antoinecellerier/lowpower-epaper-thermometer/hardware/thermometer-c6/HAND-ROUTING.md

# Hand placing & routing workflow (KiCad GUI → generator harvest)

The generated `thermometer-c6.kicad_pcb` is never hand-edited. All GUI work
happens on a copy; results flow back into `generator/pcb_layout.py` and are
re-rendered. Worklist: whatever `verify/drc_summary.py --gate` and
`verify/hand_diff.py` report. (It used to be `out/stragglers.txt`, but that file
is written only by the retired `make route`, and the board has been
0-unconnected since the J4 fanout harvest.)

**Division of labour:** steps 1–2 (and 4's GUI half) are the human part.
Steps 3, 5, 6 and the PLACE mirroring are mechanical — tell Claude which
nets you routed / which refs you moved and where the copy lives (default
`out/hand/`), and it ports everything back, gates, and commits.

## 0. Preconditions

```bash
make check          # must be fully green
make pcb            # fresh render of placement + checked-in routes
```

## 1. Make the working copy

```bash
make hand
```

Open `out/hand/thermometer-c6.kicad_pcb`. Same basenames = the GUI DRC
enforces the real rules (0.2mm netclass clearance, HV 0.3mm, 0.18mm inside
the `fpc-fanout` area, 0.5mm power widths). `out/` is gitignored.

The target copies the `.kicad_dru` along — **do not skip it.** Without it the
GUI, and any `kicad-cli pcb drc` run from that directory, silently drops every
scoped waiver rule and reports violations the real board does not have (68 vs
7, observed 2026-07-20).

It also symlinks `local.3dmodels/` into the copy, so the local STEP models
(MINI-1, USB-C, FPC, JST, both Bosch LGAs, the switch) render in the GUI's 3D
viewer. The board stores model paths as `${KIPRJMOD}/local.3dmodels/…`, and
`KIPRJMOD` resolves to whatever directory holds the `.kicad_pro` — so without
the link those parts show as bare pads in `out/hand/` while looking fine at
the top level.

`make hand` refuses if the existing copy is newer than the generated board,
since that means un-harvested GUI edits; `make hand FORCE=1` discards them.

## 2. Route in the GUI

- Targets: whatever the gate reports unrouted. Ignore GND ratsnest —
  it waits for the M6 pour.
- Route the NE-gate cluster (`EPD_CS`/`EPD_DC`/`EPD_RST`/`EPD_BUSY`/
  `~EPD_VPP`) in one sitting: the five contend for the same gate, partial
  harvests there invalidate each other.
- You may rip and re-route existing copper, but nothing regenerates it: since
  M5 `pcb_routes.py` **is** the copper, so anything you rip has to come back
  through the step 3 harvest. Treat *authored* copper as expensive to move (see
  `verify/net.py NET` — authored islands are listed with their `pcb_layout.py`
  line numbers).

## 3. Harvest tracks/vias back into the generator

Since M5 the whole board is hand-routed and `pcb_routes.py` is the copper
source of truth — harvest wholesale:

```bash
python3 generator/extract_tracks.py out/hand/thermometer-c6.kicad_pcb --all \
    -o generator/pcb_routes.py
python3 generator/pcb.py     # re-render, then gate (step 5)
```

Always use `-o` (atomic write) — **never a shell `>` redirect**, which
truncates `pcb_routes.py` before the harvester's own imports run.
Anonymous nets are renamed to their `~` names automatically (needs
`out/netlist.net`; run `make netlist` once if missing). Per-net mode
(`... NET [NET ...]`, prints entries for pasting) still exists for
surgical work.

## 3.5. Audit unharvested edits

`extract_tracks.py` mirrors only signal copper (GND excluded). Everything
else — placement, GND vias/tracks, silk, copper graphics, outline — is
hand-mirrored and easy to forget. Audit the whole round-trip:

```bash
python3 verify/hand_diff.py            # must exit 0 before the gate
python3 verify/hand_diff.py --apply    # mirror placement + STITCH vias
```

`--apply` writes the moved-footprint `PLACE` tuples and added/removed GND
`STITCH` vias into `pcb_layout.py` (unique line match required, atomic
write), then tells you to regenerate. GND tracks, silk, copper graphics and
signal-copper sync are report-only — harvest them per the report's hints.
hand_diff must exit 0 (fully mirrored) before step 5's gate.

## 4. Placement tweaks (two traps)

- Nothing harvests placement automatically. `hand_diff` catches this — its
  A section reports every moved/rotated/flipped footprint and `--apply`
  writes the `pcb_layout.PLACE` tuple for you. By hand the entries are
  `(x, y, rot[, "B"])` in **board-relative mm, origin (100,100)** — subtract
  100 from each KiCad-shown absolute coordinate; rotation is
  `SetOrientationDegrees` semantics (what the GUI shows).
- Authored TRACKS/VIAS are absolute coordinates and do **not** follow a
  moved component. hand_diff catches this too: its A section WARNs when a
  move orphans authored copper (a TRACKS vertex, VIA or STITCH via) inside
  the old courtyard. Moving anything inside a hand-authored cluster (FPC
  fanout, booster core, NE-gate copper, EPD_VCC spine) orphans that copper
  and it must be re-authored. Cheapest tweaks are in the all-A* west/center
  signal field; the east side is expensive.
- Known negative result: moving C10/R9 does NOT free `XTAL_32K_P`;
  [PATHFINDER-NOTES Stage 2](PATHFINDER-NOTES.md#stage-2-movable-authored-copper--feasibility-proven)
  holds the acid test.

## 5. Gate every iteration

```bash
make check
python3 verify/hand_diff.py            # exit 0 = every GUI edit mirrored
python3 verify/drc_summary.py --gate   # REAL=0 required
python3 verify/check_pcb.py            # trunk width, keep-out intersects
```

Unconnected items must be GND-only (the M6 pour owns GND). Beware stale
`out/drc.json` — regenerate before reading it.

## 6. Commit

Commit `pcb_layout.py` + regenerated `pcb_routes.py` + board file together
(one cluster per commit, imperative message). If a pass leaves dangling
authored copper on a *routed* net, the router bypassed your stub — delete it.

Then refresh the working copy from the freshly rendered board (step 1's `cp`
again) so the next GUI session starts from the generator's truth. Do it only
once hand_diff has nothing left to report but differences the harvest is
*meant* to absorb — pcb.py drops copper the GUI left redundant (a segment
lying wholly inside a longer collinear one on the same net/layer) and carries
any generator-side geometry fix you made on top of the harvest, and those two
are the only reasons the round-trip legitimately does not close.

## Debugging a stubborn net

`verify/reach.py NET W out.png` first (flood fill from the seed island —
shows exactly where it is walled in), then `who.py`/`gap.py`/`occupancy.py`
(the `pcb-edit` skill indexes them). Corridor truths live in LAYOUT-PLAN.md's M5
survey; router semantics (seeding, ordering, boxes) in ROUTER-NOTES.md.
