antoinecellerier/lowpower-epaper-thermometer/hardware/thermometer-c6/thermometer-c6.kicad_pcb

## KiCad design hardware/thermometer-c6/thermometer-c6.kicad_pcb (2026-10-27)

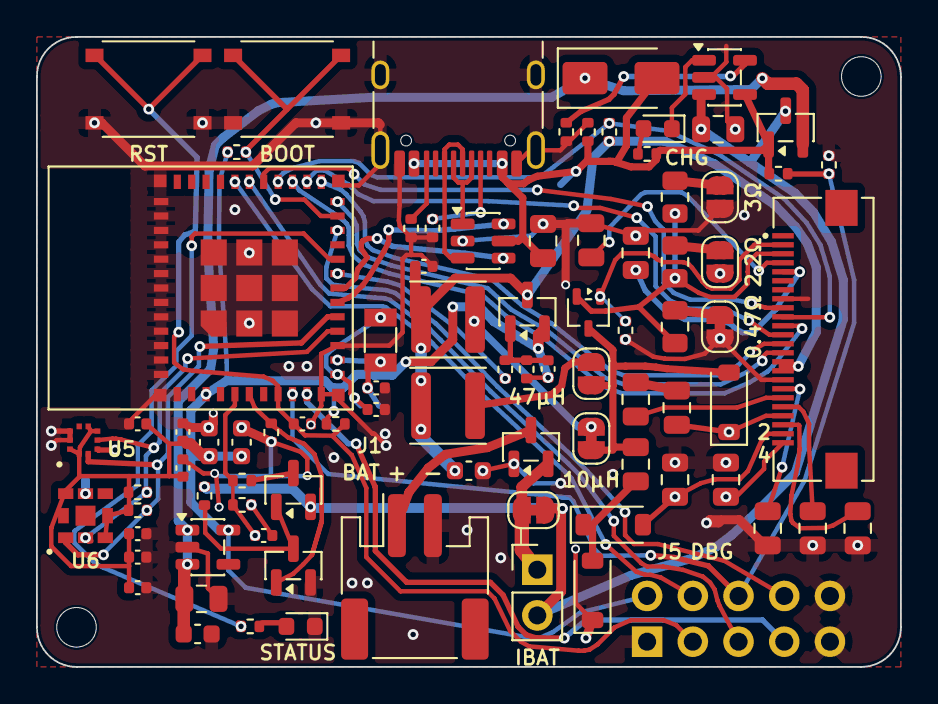
[picture p11: board thermometer-c6.kicad_pcb from above]

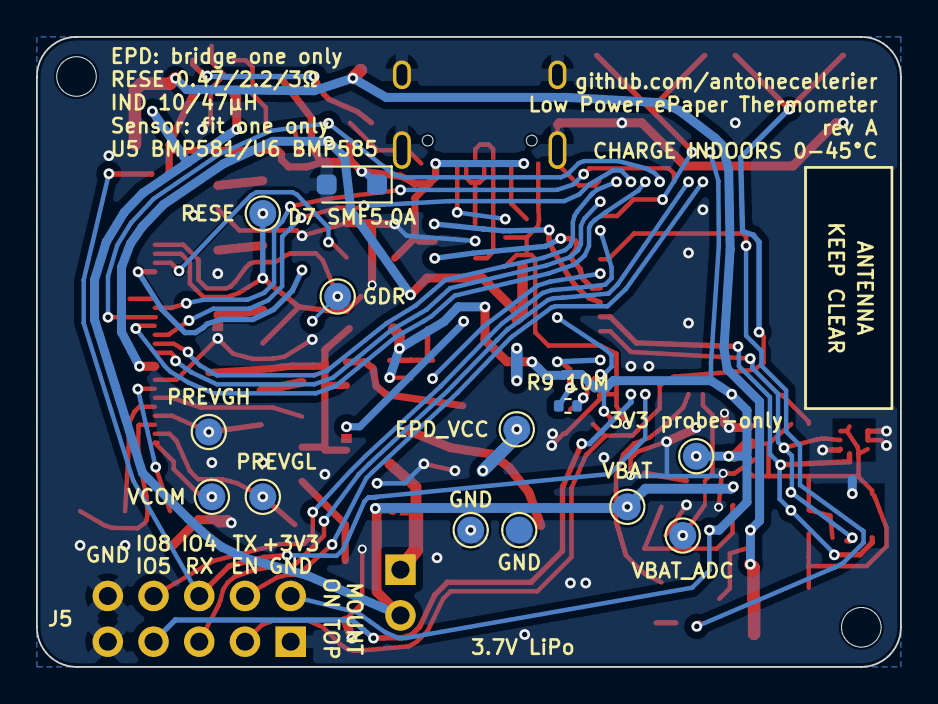
[picture p12: board thermometer-c6.kicad_pcb from below]

Board: 2 copper layers, 48.0 x 35.0 mm, 101 parts (13 on the bottom side), 60 nets.

Parts:
C1, C3, C7, C14: 10uF; C_0603_1608Metric
C2: 22uF/25V; C_0805_2012Metric
C4, C8, C12, C13, C15, C26, C27: 100nF; C_0402_1005Metric
C5, C6, C16, C17, C18, C19, C20, C23, C24: 4.7uF/50V; C_0805_2012Metric
C9: 1uF; C_0402_1005Metric
C10, C11: 20pF; C_0402_1005Metric
C21, C22, C25: 1uF/50V; C_0805_2012Metric
C28, C29: 10nF; C_0402_1005Metric
D1: CHG red; LED_0603_1608Metric
D2: SS14; D_SMA
D3: STATUS white; LED_0603_1608Metric
D4, D5, D6: MBR0530; D_SOD-123
D7: SMF5.0A; D_SOD-123F
H1, H2: M2; MountingHole_2.2mm_M2
J1: JST-PH-2 BAT; JST_PH_S2B-PH-SM4-TB_1x02-1MP_P2.00mm_Horizontal
J2: MEAS_HDR; PinHeader_1x02_P2.54mm_Vertical
J3: USB-C; USB_C_Receptacle_HRO_TYPE-C-31-M-12
J4: EPD FPC24 0.5mm; XUNPU_FPC-05FB-24PH20
J5: DEBUG; PinHeader_2x05_P2.54mm_Vertical
JP1: MEAS; SolderJumper-2_P1.3mm_Bridged_RoundedPad1.0x1.5mm
JP2: 0.47R; SolderJumper-2_P1.3mm_Bridged_RoundedPad1.0x1.5mm
JP3: 2.2R; SolderJumper-2_P1.3mm_Open_RoundedPad1.0x1.5mm
JP4: 3R; SolderJumper-2_P1.3mm_Open_RoundedPad1.0x1.5mm
JP5: L 10uH; SolderJumper-2_P1.3mm_Bridged_RoundedPad1.0x1.5mm
JP6: L 47uH; SolderJumper-2_P1.3mm_Open_RoundedPad1.0x1.5mm
L1: 10uH SWPA4030S; L_Sunlord_SWPA4030S
L2: 47uH SWPA4030S; L_Sunlord_SWPA4030S
Q1, Q2, Q4, Q6: AO3401A; SOT-23
Q3: Si1308EDL; SOT-323_SC-70
Q5: 2N7002; SOT-23
R1, R2: 5.1k; R_0402_1005Metric
R3, R6, R7, R12, R13, R17, R24: 10k; R_0402_1005Metric
R4, R8: 1k; R_0402_1005Metric
R5, R18, R19, R22, R23: 100k; R_0402_1005Metric
R9: 10M; R_0402_1005Metric
R10, R11: 4.7k; R_0402_1005Metric
R14: 0.47R 1%; R_0805_2012Metric
R15: 2.2R 1%; R_0805_2012Metric
R16: 3.0R 1%; R_0805_2012Metric
R20, R21: 100k 1%; R_0402_1005Metric
SW1: RESET; SW_TS-1187A
SW2: BOOT; SW_TS-1187A
TP1: VBAT; TestPoint_Pad_D1.5mm
TP2, TP3: GND; TestPoint_Pad_D1.5mm
TP4: 3V3; TestPoint_Pad_D1.5mm
TP5: EPD_VCC; TestPoint_Pad_D1.5mm
TP6: PREVGH; TestPoint_Pad_D1.5mm
TP7: PREVGL; TestPoint_Pad_D1.5mm
TP8: GDR; TestPoint_Pad_D1.5mm
TP9: RESE; TestPoint_Pad_D1.5mm
TP10: VCOM; TestPoint_Pad_D1.5mm
TP11: VBAT_ADC; TestPoint_Pad_D1.5mm
U1: ESP32-C6-MINI-1-N4; ESP32-C6-MINI-1
U2: RT9080-33GJ5; TSOT-23-5
U3: USBLC6-2SC6; SOT-23-6
U4: MCP73831-2; SOT-23-5
U5: BMP581; Bosch_LGA-10_2x2mm
U6: BMP585; Bosch_LGA-9_3.25x3.25mm
Y1: 32.768kHz FC-135; Crystal_SMD_3215-2Pin_3.2x1.5mm

Connections:
+3V3: C3.1, C4.1, C7.1, C8.1, C12.1, C13.1, C26.1, C27.1, C28.1, J5.2, Q2.2, R6.1, R7.1, R10.1, R11.1, R12.1, TP4.1, U1.3, U2.5, U5.1, U5.5, U5.6, U5.10, U6.3, U6.4, U6.7, U6.8
BOOT: R7.2, SW2.1, U1.23
CHG_STAT: D1.1, U4.1
DBG_IO5: J5.7, U1.10
DBG_IO8: J5.8, U1.22
DBG_RX: J5.5, U1.30
DBG_TX: J5.4, U1.31
EN: C9.1, J5.3, R6.2, SW1.1, U1.8
EPD_BUSY: J4.9, U1.29
EPD_CS: J4.12, U1.26
EPD_DC: J4.11, U1.27
EPD_GDR: J4.2, Q3.1, R13.1, TP8.1
EPD_MOSI: J4.14, U1.24
EPD_PREVGH: C17.1, D4.1, J4.21, TP6.1
EPD_PREVGL: C18.1, D6.2, J4.23, TP7.1
EPD_PWR_EN: R24.2, U1.19
EPD_RESE: J4.3, Q3.2, R14.1, R15.1, R16.1, TP9.1
EPD_RST: J4.10, R17.2, U1.28
EPD_SCK: J4.13, U1.25
EPD_SW: C16.1, D4.2, JP5.2, JP6.2, Q3.3
EPD_VCC: C14.1, C15.1, J4.15, J4.16, L1.1, L2.1, Q2.3, R17.1, TP5.1
GND: C1.2, C2.2, C3.2, C4.2, C5.2, C6.2, C7.2, C8.2, C9.2, C10.2, C11.2, C12.2, C13.2, C14.2, C15.2, C17.2, C18.2, C19.2, C20.2, C21.2, C22.2, C23.2, C24.2, C25.2, C26.2, C27.2, C29.2, D3.1, D5.1, D7.2, J1.2, J3.A1, J3.A12, J3.B1, J3.B12, J3.SH, J4.8, J4.17, J5.1, J5.9, J5.10, JP2.2, JP3.2, JP4.2, Q5.2, Q6.1, R1.2, R2.2, R3.2, R5.2, R13.2, R19.2, R21.2, R23.2, SW1.2, SW2.2, TP2.1, TP3.1, U1.1, U1.2, U1.11, U1.14, U1.36, U1.37, U1.38, U1.39, U1.40, U1.41, U1.42, U1.43, U1.44, U1.45, U1.46, U1.47, U1.48, U1.49, U1.50, U1.51, U1.52, U1.53, U2.2, U3.2, U4.2, U5.3, U5.8, U5.9, U6.6
LED_STATUS: R8.1, U1.20
unnamed: D1.2, R4.2
unnamed: D3.2, R8.2
unnamed: C16.2, D5.2, D6.1
unnamed: J1.1, Q6.3
unnamed: J2.1, JP1.1, Q6.2
unnamed: J3.A5, R1.1
unnamed: J3.B5, R2.1
unnamed: J3.A6, J3.B6, U3.3
unnamed: J3.A7, J3.B7, U3.1
unnamed: C19.1, J4.4
unnamed: C20.1, J4.5
unnamed: C21.1, J4.18
unnamed: C22.1, J4.19
unnamed: C23.1, J4.20
unnamed: C24.1, J4.22
unnamed: C25.1, J4.24, TP10.1
unnamed: JP2.1, R14.2
unnamed: JP3.1, R15.2
unnamed: JP4.1, R16.2
unnamed: JP5.1, L1.2
unnamed: JP6.1, L2.2
unnamed: C28.2, Q2.1, R12.2, R24.1
unnamed: Q4.3, R20.1
unnamed: Q4.1, Q5.3, R18.2
unnamed: R3.1, U4.5
SCL: R11.2, U1.16, U5.2, U6.1
SDA: R10.2, U1.15, U5.4, U6.2
USB_D+: U1.18, U3.4
USB_D-: U1.17, U3.6
VBAT: C6.1, J2.2, JP1.2, Q1.3, Q4.2, R18.1, TP1.1, U4.3
VBAT_ADC: C29.1, R20.2, R21.1, TP11.1, U1.5
VBUS: C5.1, D2.2, D7.1, J3.A4, J3.A9, J3.B4, J3.B9, Q1.1, R4.1, R5.1, R22.1, U3.5, U4.4
VBUS_SENSE: J5.6, R22.2, R23.1, U1.9
VDIV_EN: Q5.1, R19.1, U1.6
VSYS: C1.1, C2.1, D2.1, Q1.2, U2.1, U2.3
XTAL_32K_N: C11.1, R9.2, U1.13, Y1.2
XTAL_32K_P: C10.1, R9.1, U1.12, Y1.1
