antoinecellerier/lowpower-epaper-thermometer/tools/hstest/hstest.cpp

// Host-side test for src/HistoryStore.cpp.
//
// Compiles the REAL store against a simulated NOR flash, so the on-flash format,
// the journal cursor logic and the ring wrap are exercised natively instead of
// only on hardware. The wrap in particular is ~4.6 years out on a real device —
// this is the only practical way to reach it.
//
// The store's state is file-static, so this includes the .cpp directly: that is
// what lets a "reboot" be simulated by clearing those statics, which is exactly
// what the cursor-rediscovery path needs to be tested against.
//
// Writes model NOR semantics (program can only clear bits), so writing over a
// non-blank slot corrupts it here just as it would on the device.

#include <stdio.h>
#include <stdlib.h>
#include <string.h>
#include <time.h>

#include <cstdint>
#include <vector>

#include "esp_chip_info.h"
#include "esp_mac.h"
#include "esp_partition.h"

// Small partition so the ring wraps in seconds rather than years.
#define FAKE_PART_SIZE (0x5000u + 8u * 4096u)

static std::vector<uint8_t> g_flash;
static esp_partition_t g_part;
static bool g_have_part = true;
static size_t g_erase_count, g_write_count;

const esp_partition_t *esp_partition_find_first(esp_partition_type_t,
                                                esp_partition_subtype_t,
                                                const char *)
{
  return g_have_part ? &g_part : nullptr;
}

// Counted, because on real hardware it is the per-CALL overhead that matters,
// not the bytes: a scan doing one read per 16-byte slot overran the 5s task
// watchdog and boot-looped the device. Bytes are free here, calls are not.
static size_t g_read_count;

esp_err_t esp_partition_read(const esp_partition_t *, size_t off, void *dst, size_t n)
{
  if (off + n > g_flash.size()) return -1;
  g_read_count++;
  memcpy(dst, g_flash.data() + off, n);
  return ESP_OK;
}

esp_err_t esp_partition_write(const esp_partition_t *, size_t off, const void *src, size_t n)
{
  if (off + n > g_flash.size()) return -1;
  if (off % 4 || n % 4) { printf("FAIL: unaligned write off=%zu n=%zu\n", off, n); exit(1); }
  const uint8_t *s = (const uint8_t *)src;
  for (size_t i = 0; i < n; i++)
    g_flash[off + i] &= s[i];  // NOR: program only clears bits
  g_write_count++;
  return ESP_OK;
}

esp_err_t esp_partition_erase_range(const esp_partition_t *, size_t off, size_t n)
{
  if (off % 4096 || n % 4096) { printf("FAIL: unaligned erase off=%zu n=%zu\n", off, n); exit(1); }
  if (off + n > g_flash.size()) return -1;
  memset(g_flash.data() + off, 0xFF, n);
  g_erase_count += n / 4096;
  return ESP_OK;
}

// Overridable so --inject can stamp a real device's MAC and have it accept the
// image as its own.
static uint8_t g_mac[6] = { 0x24, 0x6f, 0x28, 0xab, 0xcd, 0xef };

int esp_efuse_mac_get_default(uint8_t *mac)
{
  memcpy(mac, g_mac, 6);
  return ESP_OK;
}

void esp_chip_info(esp_chip_info_t *out) { out->model = 1; out->revision = 3; }

#include "../../src/HistoryStore.cpp"
#include "MockData.h"

// --- harness ----------------------------------------------------------------

static int g_fail;
#define CHECK(cond, ...) do { if (!(cond)) { \
    printf("FAIL %s:%d: ", __FILE__, __LINE__); printf(__VA_ARGS__); \
    printf("\n"); g_fail++; } } while (0)

// Clear the store's module state — the device equivalent of a cold boot.
static void reboot(void)
{
  s_part = nullptr;
  s_ready = s_probed = s_base_dirty = false;
  s_jrn_size = 0;
  s_cursor = UINT32_MAX;
  s_base_seq = 0;
  s_base_hourly = 0;
  s_base_cursor = 0;
  s_base_off = UINT32_MAX;
}

static void power_on(bool wipe)
{
  if (wipe) { g_flash.assign(FAKE_PART_SIZE, 0xFF); }
  g_part.size = FAKE_PART_SIZE;
  reboot();
}

static RtcHistory g_hist;
static HistoryDriftState g_drift;

static void reset_hist(void)
{
  memset(&g_hist, 0, sizeof(g_hist));
  g_hist.version = RTC_HISTORY_VERSION;
  g_hist.current_hour_min_x10 = 9990;
  g_hist.current_hour_max_x10 = -9990;
  memset(&g_drift, 0, sizeof(g_drift));
}

static void ring_push(time_t hour, int16_t mn, int16_t mx, int16_t av)
{
  HourlyEntry e = { mn, mx, av };
  g_hist.hourly[g_hist.hourly_idx] = e;
  g_hist.hourly_idx = (uint16_t)((g_hist.hourly_idx + 1) % HOURLY_HISTORY_SIZE);
  if (g_hist.hourly_count < HOURLY_HISTORY_SIZE) g_hist.hourly_count++;
  g_hist.hourly_latest_time = hour;
  history_store_append_hourly(hour, &e);
}

static const time_t T0 = 1750000000;  // 2025-06-15, comfortably "plausible"

int main(int argc, char **argv)
{
  // ---- 1. virgin partition formats and is usable ----
  power_on(true);
  reset_hist();
  CHECK(history_store_available(), "store should come up on a blank partition");
  CHECK(s_jrn_size == FAKE_PART_SIZE - HS_JOURNAL_OFF, "journal size %u",
        (unsigned)s_jrn_size);

  // ---- 2. append, snapshot, restore round-trip ----
  for (int i = 0; i < 50; i++)
    ring_push(T0 + i * 3600, (int16_t)(200 + i), (int16_t)(210 + i), (int16_t)(205 + i));
  // Sparkline points sit AFTER the newest finalized hour, as on a live device:
  // it is written on every refresh, the ring only on an hour boundary. A
  // fixture with it trailing the ring would trip the backfill and make the
  // round-trip check below compare against something restore never claims.
  g_hist.temp_count = 0;
  for (int i = 0; i < 20; i++)
    temp_history_record(g_hist.temp, &g_hist.temp_count,
                        T0 + 49 * 3600 + i * 600, (int16_t)(200 + i));

  g_drift.resync_interval_s = 86400;
  g_drift.last_drift_ms = -9559000;
  g_drift.last_drift_window_s = 1814400;
  g_drift.last_sync_time = T0;
  g_drift.drift_ppm_count = 2;
  g_drift.drift_ppm_hist[0] = -5265;
  g_drift.drift_ppm_hist[1] = -5100;
  g_drift.drift_comp_ppm = -5250;

  history_store_mark_base_dirty();
  history_store_flush(&g_hist, &g_drift, T0 + 50 * 3600);
  CHECK(s_base_seq == 1, "first base should be seq 1, got %u", (unsigned)s_base_seq);

  RtcHistory saved = g_hist;
  reboot();
  RtcHistory got;
  HistoryDriftState gotd;
  CHECK(history_store_restore(&got, &gotd), "restore after snapshot");
  CHECK(got.hourly_count == saved.hourly_count, "hourly_count %u != %u",
        got.hourly_count, saved.hourly_count);
  CHECK(memcmp(got.hourly, saved.hourly, sizeof(got.hourly)) == 0, "hourly ring differs");
  CHECK(got.temp_count == saved.temp_count, "temp_count %u != %u",
        got.temp_count, saved.temp_count);
  CHECK(memcmp(got.temp, saved.temp, sizeof(got.temp)) == 0, "sparkline differs");
  CHECK(gotd.drift_ppm_hist[0] == -5265 && gotd.drift_ppm_count == 2, "drift block lost");
  CHECK(gotd.drift_comp_ppm == -5250, "drift_comp_ppm lost");
  CHECK(gotd.last_sync_time == T0, "last_sync_time lost");

  // ---- 3. records written after the base are replayed, not double-applied ----
  reboot();
  history_store_available();
  g_hist = saved;
  for (int i = 50; i < 60; i++)
    ring_push(T0 + i * 3600, (int16_t)(200 + i), (int16_t)(210 + i), (int16_t)(205 + i));
  RtcHistory saved2 = g_hist;
  reboot();
  CHECK(history_store_restore(&got, &gotd), "restore with journal tail");
  CHECK(got.hourly_count == saved2.hourly_count,
        "replayed hourly_count %u != %u (double-apply?)", got.hourly_count,
        saved2.hourly_count);
  CHECK(memcmp(got.hourly, saved2.hourly, sizeof(got.hourly)) == 0,
        "replayed ring differs from live ring");
  CHECK(got.hourly_latest_time == saved2.hourly_latest_time,
        "replayed anchor %lld != %lld", (long long)got.hourly_latest_time,
        (long long)saved2.hourly_latest_time);

  // ---- 4. base ping-pong: a second snapshot lands in the other slot ----
  uint32_t first_slot = s_base_off;
  reboot();
  history_store_available();
  g_hist = saved2;
  history_store_mark_base_dirty();
  history_store_flush(&g_hist, &g_drift, T0 + 60 * 3600);
  CHECK(s_base_off != first_slot, "second base reused slot 0x%x", (unsigned)first_slot);
  CHECK(s_base_seq == 2, "second base seq %u", (unsigned)s_base_seq);

  // ---- 5. the monotone guard refuses an emptier ring ----
  RtcHistory empty;
  memset(&empty, 0, sizeof(empty));
  empty.version = RTC_HISTORY_VERSION;
  uint32_t seq_before = s_base_seq;
  history_store_mark_base_dirty();
  history_store_flush(&empty, &g_drift, T0 + 61 * 3600);
  CHECK(s_base_seq == seq_before, "base write from an empty ring was allowed");
  reboot();
  CHECK(history_store_restore(&got, &gotd), "archive survives the refused write");
  CHECK(got.hourly_count == saved2.hourly_count, "archive damaged: %u != %u",
        got.hourly_count, saved2.hourly_count);

  // ---- 6. ring wrap: keep appending well past the journal size ----
  reboot();
  history_store_available();
  g_hist = saved2;
  size_t slots = s_jrn_size / HS_REC;
  size_t erases_before = g_erase_count;
  for (size_t i = 0; i < slots * 3; i++)
  {
    HourlyEntry we = { (int16_t)(i & 0x7F), 210, 205 };
    history_store_append_hourly(T0 + (time_t)i * 3600, &we);
    if ((i % 500) == 0)
    {
      // Rediscover the cursor from scratch, as a cold boot would.
      uint32_t seq = s_base_seq, hc = s_base_hourly, bc = s_base_cursor, bo = s_base_off;
      reboot();
      s_part = &g_part; s_ready = s_probed = true;
      s_jrn_size = FAKE_PART_SIZE - HS_JOURNAL_OFF;
      s_base_seq = seq; s_base_hourly = hc; s_base_cursor = bc; s_base_off = bo;
      CHECK(journal_locate(), "cursor lost after wrap at i=%zu", i);
      CHECK(s_cursor < s_jrn_size, "cursor 0x%x out of range at i=%zu",
            (unsigned)s_cursor, i);
    }
  }
  CHECK(g_erase_count > erases_before, "ring never erased a sector while wrapping");
  printf("wrap: %zu appends over %zu slots, %zu sector erases\n",
         slots * 3, slots, g_erase_count - erases_before);

  // ---- 7. a snapshot still works after wrapping, and restores ----
  history_store_mark_base_dirty();
  history_store_flush(&g_hist, &g_drift, T0 + 100 * 3600);
  reboot();
  CHECK(history_store_restore(&got, &gotd), "restore after wrap");
  CHECK(got.hourly_count == saved2.hourly_count, "post-wrap hourly %u != %u",
        got.hourly_count, saved2.hourly_count);

  // ---- 7b. a two-slot record landing on the last slot must not leave a hole ----
  // REC_DRIFT needs two slots, so at the ring end it has to wrap. Leaving the
  // final slot erased made it a permanent 0xFF gap that journal_scan() reports
  // as the cursor ahead of everything written after the wrap.
  power_on(true);
  reset_hist();
  history_store_available();
  g_hist.hourly_count = 1;
  history_store_mark_base_dirty();
  history_store_flush(&g_hist, &g_drift, T0);
  journal_locate();
  s_cursor = s_jrn_size - HS_REC;          // park on the very last slot
  {
    HistoryDriftSample ds;
    memset(&ds, 0, sizeof(ds));
    ds.sync_time = T0;
    ds.ppm = -5265;
    history_store_append_drift(&ds);       // must pad the tail, then wrap
  }
  CHECK(s_cursor == HS_REC * 2, "drift record did not wrap to slot 0 (cursor 0x%x)",
        (unsigned)s_cursor);
  {
    uint8_t tail[HS_REC];
    memcpy(tail, g_flash.data() + HS_JOURNAL_OFF + s_jrn_size - HS_REC, HS_REC);
    CHECK(tail[0] != REC_FREE, "the ring's last slot was left erased");
  }
  // A hole would make the scan stop short of the post-wrap records.
  {
    HourlyEntry pe = { 500, 510, 505 };
    history_store_append_hourly(T0 + 7200, &pe);
  }
  s_cursor = UINT32_MAX;
  CHECK(journal_locate(), "cursor lost after the padded wrap");
  CHECK(s_cursor == HS_REC * 3, "scan stopped at the padded slot (cursor 0x%x)",
        (unsigned)s_cursor);

  // ---- 8. a base gets written without any NTP resync ever succeeding ----
  // Restore needs a base to anchor to, so appending alone must eventually
  // demand one; otherwise a device whose clock never syncs journals records it
  // could never restore.
  power_on(true);
  reset_hist();
  history_store_available();
  // store_init() asks for a base as soon as it finds none, so the sparkline
  // is persisted from the first sleep rather than the first hour boundary.
  CHECK(s_base_dirty, "a store with no base should request one at init");
  {
    HourlyEntry e = { 200, 210, 205 };
    history_store_append_hourly(T0, &e);
  }
  CHECK(s_base_dirty, "first append with no base must request one");
  g_hist.hourly_count = 1;
  history_store_flush(&g_hist, &g_drift, T0);
  CHECK(s_base_seq == 1, "base should exist after the first flush");
  // And again on the RPO: 24 hourly records is 24 clock hours, so a day of data
  // is the most a reflash can cost. Checked exactly, since firing early would
  // quietly multiply the snapshot energy and firing late would break the
  // guarantee. This must hold without any NTP resync marking the base dirty.
  s_base_dirty = false;
  for (size_t i = 0; i < HS_BASE_MAX_RECORDS - 1; i++)
  {
    HourlyEntry se = { 200, 210, 205 };
    history_store_append_hourly(T0 + (time_t)i * 3600, &se);
    CHECK(!s_base_dirty, "base requested after only %u records", (unsigned)(i + 1));
  }
  {
    HourlyEntry se = { 200, 210, 205 };
    history_store_append_hourly(T0 + (time_t)HS_BASE_MAX_RECORDS * 3600, &se);
  }
  CHECK(s_base_dirty, "a day of records must request a fresh base");

  // ---- 9. foreign content (old app image) is detected and formatted ----
  power_on(true);
  srand(1);
  for (auto &b : g_flash) b = (uint8_t)rand();
  reset_hist();
  CHECK(history_store_available(), "store should format over foreign content");
  CHECK(!history_store_restore(&got, &gotd), "nothing to restore after format");

  // ---- 9a. the ring rebuilds from the journal when no base survives ----
  // Both ping-pong slots gone but the journal intact: every record carries its
  // own hour and CRC, so the archive is not lost. This used to bail out and
  // strand years of perfectly readable data.
  power_on(true);
  reset_hist();
  history_store_available();
  for (int i = 0; i < 30; i++)
    ring_push(T0 + i * 3600, (int16_t)(150 + i), (int16_t)(250 + i), (int16_t)(200 + i));
  history_store_mark_base_dirty();
  history_store_flush(&g_hist, &g_drift, T0 + 30 * 3600);
  for (int i = 30; i < 40; i++)   // journal-only tail, after the snapshot
    ring_push(T0 + i * 3600, (int16_t)(150 + i), (int16_t)(250 + i), (int16_t)(200 + i));
  memset(g_flash.data() + HS_BASE_A_OFF, 0x00, HS_BASE_SIZE);   // clobber both
  memset(g_flash.data() + HS_BASE_B_OFF, 0x00, HS_BASE_SIZE);
  reboot();
  memset(&got, 0, sizeof(got));
  // Guarded: with the rebuild absent every check below would index an empty
  // ring, and a segfault is a worse regression report than a failed CHECK.
  if (!history_store_restore(&got, &gotd) || got.hourly_count != 40)
  {
    CHECK(false, "journal-only restore rebuilt %u hours, want 40",
          (unsigned)got.hourly_count);
  }
  else
  {
    CHECK(got.hourly_latest_time == T0 + 39 * 3600, "rebuilt anchor %lld != %lld",
          (long long)got.hourly_latest_time, (long long)(T0 + 39 * 3600));
    // Oldest and newest must land where Display.h expects to read them.
    uint16_t s0 = (got.hourly_count < HOURLY_HISTORY_SIZE) ? 0 : got.hourly_idx;
    const HourlyEntry &oldest = got.hourly[s0];
    const HourlyEntry &newest =
        got.hourly[(uint16_t)((s0 + got.hourly_count - 1) % HOURLY_HISTORY_SIZE)];
    CHECK(oldest.avg_x10 == 200, "rebuilt oldest avg %d != 200", oldest.avg_x10);
    CHECK(newest.avg_x10 == 239, "rebuilt newest avg %d != 239", newest.avg_x10);
    // The sparkline lives only in the snapshot, so it must come from the ring.
    CHECK(got.temp_count > 0, "sparkline not backfilled from hourly data");
    CHECK(got.temp_count > 0 &&
              (time_t)got.temp[got.temp_count - 1].timestamp == T0 + 39 * 3600,
          "backfilled sparkline does not end at the newest hour");
  }

  // ---- 9a2. the rebuild must stay cheap on an empty/erased journal ----
  // This is the case a cold boot right after erase_flash hits, and it has to be
  // fast: the first version scanned slot by slot, took >5s on real flash, and
  // tripped the task watchdog into a boot loop. Bytes are free in this harness,
  // so bound the CALL count — that is what costs on hardware.
  power_on(true);
  reset_hist();
  history_store_available();
  {
    // A wiped partition with a store header and nothing else.
    g_read_count = 0;
    RtcHistory empty;
    memset(&empty, 0, sizeof(empty));
    HistoryDriftState emptyd;
    CHECK(!history_store_restore(&empty, &emptyd),
          "nothing to restore from an empty journal");
    const size_t slots = s_jrn_size / HS_REC;
    CHECK(g_read_count < slots / 8,
          "empty-journal rebuild did %zu flash reads over %zu slots — "
          "not skipping erased regions", g_read_count, slots);
  }

  // ---- 9b. a format bump must never erase the archive ----
  // The whole point of the partition is surviving firmware updates, so a
  // version skew has to be inert. Build a populated store, then bump the
  // on-flash format byte the way shipping a new HS_FORMAT would.
  power_on(true);
  reset_hist();
  history_store_available();
  {
    HourlyEntry fe = { 111, 222, 175 };
    history_store_append_hourly(T0, &fe);
  }
  g_hist.hourly_count = 1;
  history_store_mark_base_dirty();
  history_store_flush(&g_hist, &g_drift, T0);
  {
    HsStoreHeader hdr;
    memcpy(&hdr, g_flash.data() + HS_HDR_OFF, sizeof(hdr));
    hdr.format = HS_FORMAT + 1;
    hdr.crc32 = crc32_of(&hdr, offsetof(HsStoreHeader, crc32));
    memcpy(g_flash.data() + HS_HDR_OFF, &hdr, sizeof(hdr));
  }
  g_erase_count = 0;
  reboot();
  CHECK(!history_store_available(), "a foreign format must disable the store");
  CHECK(g_erase_count == 0, "a foreign format erased %u sectors — must be 0",
        (unsigned)g_erase_count);
  {
    HsBaseHeader bh;
    memcpy(&bh, g_flash.data() + HS_BASE_A_OFF, sizeof(bh));
    CHECK(bh.magic == HS_MAGIC && bh.hourly_count == 1,
          "the base snapshot must survive a format bump untouched");
  }

  // ---- 9c. a damaged header is repaired without erasing the archive ----
  // The header is written once and never rewritten, so a bad one is a torn
  // first write or a bit flip — not grounds to erase the records behind it.
  {
    HsStoreHeader hdr;
    memcpy(&hdr, g_flash.data() + HS_HDR_OFF, sizeof(hdr));
    hdr.format = HS_FORMAT;
    hdr.crc32 ^= 0x5A5A5A5Au;   // plausible header, broken CRC
    memcpy(g_flash.data() + HS_HDR_OFF, &hdr, sizeof(hdr));
  }
  g_erase_count = 0;
  reboot();
  CHECK(history_store_available(), "a damaged header should be repaired");
  CHECK(g_erase_count == 1, "header repair erased %u sectors — must be 1",
        (unsigned)g_erase_count);
  memset(&got, 0, sizeof(got));
  CHECK(history_store_restore(&got, &gotd), "archive must survive header repair");
  CHECK(got.hourly_count == 1, "restored %u hourly after header repair, want 1",
        (unsigned)got.hourly_count);

  // ---- 9d. no-free-slot recovery must not eat the unabsorbed records ----
  // A torn erase leaves the ring with no 0xFF gap. The sector reclaimed to
  // recover must not be the one holding records written since the last
  // snapshot — those are the only copy.
  power_on(true);
  reset_hist();
  history_store_available();
  {
    HourlyEntry re = { 300, 310, 305 };
    history_store_append_hourly(T0, &re);
  }
  g_hist.hourly_count = 1;
  history_store_mark_base_dirty();
  history_store_flush(&g_hist, &g_drift, T0);
  {
    HourlyEntry re = { 400, 410, 405 };   // after the snapshot: journal-only
    history_store_append_hourly(T0 + 3600, &re);
  }
  // Break the erase-ahead invariant without touching written records: mark
  // every free slot as occupied by something journal_scan() won't skip.
  for (uint32_t off = 0; off < s_jrn_size; off += HS_REC)
    if (g_flash[HS_JOURNAL_OFF + off] == REC_FREE)
      g_flash[HS_JOURNAL_OFF + off] = 0x7E;
  reboot();
  memset(&got, 0, sizeof(got));
  CHECK(history_store_restore(&got, &gotd), "restore should survive the reclaim");
  CHECK(got.hourly_count == 2,
        "reclaim lost the unabsorbed record: %u hourly restored, want 2",
        (unsigned)got.hourly_count);

  // ---- 9e. counts in the payload are clamped, not trusted ----
  // The CRC proves the bytes are the ones that were written, not that they were
  // sane when written. Everything downstream indexes the arrays off these
  // without a bound of its own, and a bad snapshot is re-restored on every cold
  // boot — so an unclamped count is a panic loop no reflash can clear.
  power_on(true);
  reset_hist();
  history_store_available();
  g_hist.temp_count = 5;
  g_hist.hourly_count = 3;
  g_hist.hourly_idx = 3;
  history_store_mark_base_dirty();
  history_store_flush(&g_hist, &g_drift, T0);
  {
    // Corrupt the counts in place and re-CRC, exactly as a bad-but-verified
    // snapshot or an edited image would look.
    uint32_t slot = (s_base_off == HS_BASE_A_OFF) ? HS_BASE_A_OFF : HS_BASE_B_OFF;
    HsBaseHeader bh;
    memcpy(&bh, g_flash.data() + slot, sizeof(bh));
    RtcHistory bad;
    memcpy(&bad, g_flash.data() + slot + sizeof(bh), sizeof(bad));
    bad.temp_count = 65535;
    bad.hourly_count = 60000;
    bad.hourly_idx = 40000;
    memcpy(g_flash.data() + slot + sizeof(bh), &bad, sizeof(bad));
    uint32_t c = crc32_up(crc32_begin(), &bh, offsetof(HsBaseHeader, crc32));
    c = crc32_up(c, &bad, sizeof(bad));
    c = crc32_up(c, g_flash.data() + slot + sizeof(bh) + sizeof(bad),
                 sizeof(HistoryDriftState));
    bh.crc32 = crc32_end(c);
    memcpy(g_flash.data() + slot, &bh, sizeof(bh));
  }
  reboot();
  memset(&got, 0, sizeof(got));
  CHECK(history_store_restore(&got, &gotd), "a CRC-valid snapshot still restores");
  CHECK(got.temp_count <= TEMP_HISTORY_SIZE, "temp_count %u not clamped",
        (unsigned)got.temp_count);
  CHECK(got.hourly_count <= HOURLY_HISTORY_SIZE, "hourly_count %u not clamped",
        (unsigned)got.hourly_count);
  CHECK(got.hourly_idx < HOURLY_HISTORY_SIZE, "hourly_idx %u not clamped",
        (unsigned)got.hourly_idx);

  // ---- 10. a missing partition degrades instead of crashing ----
  g_have_part = false;
  reboot();
  CHECK(!history_store_available(), "should report unavailable with no partition");
  {
    HourlyEntry ne = { 200, 210, 205 };
    history_store_append_hourly(T0, &ne);   // must not crash
  }
  history_store_mark_base_dirty();
  history_store_flush(&g_hist, &g_drift, T0);
  g_have_part = true;

  // ---- optional: emit a full-size image to inject onto a real device ----
  // `--inject <part-size> <mac-hex> <now-epoch> <file>` writes an image that a
  // device will accept as its own, filled with MockData's 30-day profile — the
  // same data the simulator renders, so the on-screen result can be compared
  // against tools/mock_200x200.png. Beats waiting 30 days for a real chart.
  //
  // Built by the REAL store code, so the injected image cannot disagree with
  // what the firmware writes.
  if (argc > 5 && strcmp(argv[1], "--inject") == 0)
  {
    g_flash.assign((size_t)strtoul(argv[2], nullptr, 0), 0xFF);
    g_part.size = (uint32_t)g_flash.size();
    sscanf(argv[3], "%2hhx:%2hhx:%2hhx:%2hhx:%2hhx:%2hhx", &g_mac[0], &g_mac[1],
           &g_mac[2], &g_mac[3], &g_mac[4], &g_mac[5]);
    time_t now = (time_t)strtoll(argv[4], nullptr, 0);
    reboot();
    reset_hist();
    history_store_available();

    mock_fill_hourly(now, g_hist.hourly, &g_hist.hourly_count,
                     &g_hist.hourly_idx, &g_hist.hourly_latest_time);
    // argv[6] == "ramp" replaces the sparkline with a clean 10->30C diagonal at
    // a fixed 30min spacing. Nothing the room or MockData produces looks like
    // that, so seeing it on the 24h chart proves the flash path unambiguously.
    if (argc > 6 && strcmp(argv[6], "ramp") == 0)
    {
      g_hist.temp_count = 0;
      for (int i = 0; i < 48; i++)
        temp_history_record(g_hist.temp, &g_hist.temp_count,
                            now - (time_t)(47 - i) * 1800,
                            (int16_t)(100 + i * (300 - 100) / 47));
      printf("sparkline: 10.0-30.0C ramp, 48 points at 30min\n");
    }
    else
    {
      mock_fill_sparkline(now, g_hist.temp, &g_hist.temp_count);
    }
    // Journal `hours` of history (argv[7], default = one ring's worth). Going
    // past HOURLY_HISTORY_SIZE is the interesting case: the journal is the
    // long-term archive and keeps everything, while the base snapshot only
    // carries what RTC can hold. Beyond the ring the two legitimately diverge,
    // and only the journal has the older hours.
    long hours = (argc > 7) ? strtol(argv[7], nullptr, 0) : g_hist.hourly_count;
    if (hours < 1) hours = 1;
    for (long k = hours - 1; k >= 0; k--)
    {
      time_t hr = g_hist.hourly_latest_time - (time_t)k * 3600;
      // Same daily profile MockData draws, so an 83-day series still looks like
      // weather rather than noise.
      struct tm t;
      localtime_r(&hr, &t);
      float c = mock_temp_at_hour((float)t.tm_hour) + 0.02f * (float)((hours - k) / 24);
      HourlyEntry e = { (int16_t)((c - 0.4f) * 10), (int16_t)((c + 0.4f) * 10),
                        (int16_t)(c * 10) };
      history_store_append_hourly(hr, &e);
    }
    printf("journal: %ld hourly records (%.1f days); RTC ring holds %u\n",
           hours, hours / 24.0, g_hist.hourly_count);
    // A self-consistent drift block: an interval the scheduler will accept,
    // and a ppm sample paired with the window it was measured over. Leaving
    // either unset is not harmless — a zero interval schedules a WiFi resync
    // on every wake, and a zero window makes the on-screen weighted mean
    // collapse to +0ppm.
    g_drift.resync_interval_s = 86400;
    g_drift.last_sync_time = now;
    g_drift.last_drift_ms = -9559000;
    g_drift.last_drift_window_s = 1814400;
    g_drift.drift_ppm_count = 1;
    g_drift.drift_ppm_hist[0] = -5265;
    g_drift.drift_win_min[0] = 1814400 / 60;
    history_store_mark_base_dirty();
    history_store_flush(&g_hist, &g_drift, now);

    FILE *f = fopen(argv[5], "wb");
    fwrite(g_flash.data(), 1, g_flash.size(), f);
    fclose(f);
    printf("injected image: %u hourly, %u sparkline, %zu bytes\n",
           g_hist.hourly_count, g_hist.temp_count, g_flash.size());
    return g_fail ? 1 : 0;
  }

  // ---- optional: emit an image for the Python decoder to cross-check ----
  if (argc > 1)
  {
    // Recorded alongside the image so check_sample.py can assert the Python
    // decoder sees exactly this. Printing a decode proves nothing on its own.
    const int kHourly = 40, kSparkline = 12, kDrift = 1;

    power_on(true);
    reset_hist();
    history_store_available();
    for (int i = 0; i < kHourly; i++)
      ring_push(T0 + i * 3600, (int16_t)(180 + i), (int16_t)(220 + i), (int16_t)(200 + i));
    for (int i = 0; i < kSparkline; i++)
    {
      temp_history_record(g_hist.temp, &g_hist.temp_count, T0 + i * 900,
                          (int16_t)(195 + i));
    }
    g_drift.last_sync_time = T0;
    g_drift.drift_ppm_count = 1;
    g_drift.drift_ppm_hist[0] = -5265;
    g_drift.drift_comp_ppm = -5250;   // exercises the decoder's "armed" line
    history_store_mark_base_dirty();
    history_store_flush(&g_hist, &g_drift, T0 + 40 * 3600);
    HistoryDriftSample ds = {};
    ds.sync_time = T0 + 40 * 3600;
    ds.drift_ms = -9559000;
    ds.window_s = 1814400;
    ds.ppm = -5268;   // = drift_ms * 1000 / window_s, or it decodes as compensation
    ds.ambient_mean_x10 = 213;
    ds.ambient_hours = 40;
    ds.boot_count = 847;
    ds.refresh_count = 203;
    history_store_append_drift(&ds);
    FILE *f = fopen(argv[1], "wb");
    fwrite(g_flash.data(), 1, g_flash.size(), f);
    fclose(f);
    printf("wrote sample image %s (%zu bytes)\n", argv[1], g_flash.size());

    char expect_path[512];
    snprintf(expect_path, sizeof(expect_path), "%s.expect", argv[1]);
    FILE *e = fopen(expect_path, "w");
    if (e)
    {
      // Last column is journal-decoded hourly records: every ring_push() also
      // journals, and the check needs the journal walk verified on its own.
      fprintf(e, "%d %d %d %d\n", kHourly, kSparkline, kDrift, kHourly);
      fclose(e);
    }
  }

  printf(g_fail ? "\n%d CHECK(s) FAILED\n" : "\nall checks passed (%d failures)\n",
         g_fail);
  return g_fail ? 1 : 0;
}
