antoinecellerier/lowpower-epaper-thermometer/tools/docwrap.py

#!/usr/bin/env python3
"""Check or fix paragraph wrapping in a markdown doc (.claude/rules/docs-style.md).

  docwrap.py check FILE...           -> lines over WIDTH+20, ragged paragraphs, links or
                                        code spans split across lines; exit 1 if any
  docwrap.py fix   FILE[:START]...   -> reflow the offending paragraphs and list items at
                                        WIDTH, whitespace only; START skips earlier lines

Never touched: tables, headings, code fences, image lines, blocks of one-word lines.
Links `[text](url)` and code spans `...` are never split; a span longer than WIDTH
stays on its own line. A block with an unpaired backtick is reported, not reflowed.
"""
import re, sys, textwrap

WIDTH = 80
NB = ''  # placeholder for spaces inside links and code spans

def protect(t):
    t = re.sub(r'\[[^\]]*\]\([^)]*\)', lambda m: m.group(0).replace(' ', NB), t)
    t = re.sub(r'`[^`]*`', lambda m: m.group(0).replace(' ', NB), t)
    return t

def prose(l):
    return bool(l.strip()) and l == l.lstrip() and not re.match(r'(- |\* |> |#|\||!\[)', l) \
        and not l.startswith('```')

ITEM = re.compile(r'^( *)([-*] )')

def item(l): return ITEM.match(l) is not None

def cont(l, indent):
    """A continuation of a list item: indented past its marker and not a marker itself."""
    return l.strip() != '' and l.startswith(' ' * indent) and not ITEM.match(l)
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
