antoinecellerier/lowpower-epaper-thermometer/(commit log)

2026-09-16 Add driftstats.py: the harvest rate and covariate tables from an archive image
    The August correlations and partials were computed by hand and never
    committed. This reproduces every published figure from the images: arm 0
    +5066.3, arm 1 +5124.6 (partials -0.044/+0.200/-0.005), arm 3 +607.2,
    arm 5 +877.9 with the +28.7 ppm/day elapsed-time slope.
    [driftstats.py]
2026-09-16 Harvest arm 2: +4801 ppm against a pre-registered +4790
    Twelve times the repaint count on the same pinned wake cadence lowers the
    FireBeetle's rate by 6.3%, which is what the awake/asleep mixture predicts if
    awake time is XTAL-clocked. Solving both arms puts the sleep path at ~+5213 ppm
    and the awake path near zero. The ambient slope did not move, so the awake path
    is not behind the sign disagreement arm 1 left open.
2026-09-16 Harvest arm 4: pinning the C6 hat does not tighten its scatter
    +320 ppm over 42 windows at +-100%, against arm 3's +607 at +-96% on the same
    board. The relative scatter is unchanged and every covariate reads zero, so the
    C6's dispersion is not a duty-cycle artefact. The wake counter still reads
    ambient at -2.3 wakes/day per degC.
2026-09-16 Harvest arm 5's second leg: the rate rose to +1322 ppm and then plateaued
    45 clean windows at +-54%. The +28.7 ppm/day climb of the first leg is
    +2.3 ppm/day here; the level stepped between legs, across the August RST, and
    nothing journaled separates a reset effect from a drifting rate. driftstats.py
    gains --since to cut an archive at a date.
    [driftstats.py]
2026-09-16 Add on-device clock-drift compensation, FireBeetle rig only
    The rate is learned from the resync ring (window-weighted, 0.75 decay per
    sample of age) and applied with settimeofday() at every HP wake, so the resync
    measures only the residual and the adaptive interval can leave its 1-day floor.
    The ring and the journal's ppm keep the raw rate; the journal's drift_ms keeps
    the residual, so the host recovers the applied level from the two. Persisted in
    HistoryDriftState across reflashes. Footer shows c<ppm> while armed.
    Gates: hstest sample, sim screenshots, E and C6 release builds; RTC headroom
    64 -> 48 B on the E.
    [Display.h, DisplayRenderer.cpp, HistoryStore.h, Thermometer.cpp, driftstats.py, history.py]
2026-09-16 Arm drift compensation from the restored ring at boot
    A snapshot written before drift_comp_ppm existed restores six usable rates and
    a zero level, which left the first day after a flash uncorrected.
    [Thermometer.cpp]
2026-09-16 Reword the flash archive validation log to the docs style rule
    Split the single observations table into device-state rows (every flash,
    erase and inject with env, flags, hash), harvest rows and one-line
    results, with short detail sections for bugs and mechanisms. Four bench
    traps the log used to carry move to the device-session skill. All
    figures, hashes, archive paths and dates are kept; the 31 tokens the
    inventory diff reports are spelling variants and rounded restatements.
2026-09-16 Reword the power logbook to the docs style rule
    Entries from July 2026 on follow the entry template: neutral heading,
    result, conditions, tables with n and source, one paragraph, open list.
    The four deferred and unmeasured lists merge into one open-items table.
    Three PPK2 reading lessons move to the device-session skill. The 2021 to
    April 2026 entries are untouched. All capture paths, hashes, figures and
    dates are kept; the 27 tokens the inventory diff reports are spelling
    variants, rounded restatements and superseded threshold predictions.
2026-09-16 Track the logbook inventory diff and the wrap checker as restructuring gates
    tools/docinv.py is the scratchpad script the logbook rewrites were checked with; tools/docwrap.py checks wrapping and never splits a link or code span. The docs style rule now requires both diff directions, a second reader, that rewrites keep every hedge, 80-column prose, and that a Results table row follows the entry that supersedes it.
2026-09-16 Move PPK2 captures and photos under docs/captures and docs/photos
    Every citation is now a relative link that opens; the abbreviated
    suffix citations in notes.md are expanded to full names. The docs style
    rule and the device-session skill name the two directories.
2026-09-16 Cut the readme power section to the table and pointers
    Derived runtime figures that live nowhere else stay, with the logbook's
    qualifiers restored; everything the power logbook already holds with
    conditions becomes a link to its entry. One bold per @4V2 bat figure,
    per the docs style rule.
2026-09-16 Open the power logbook with a per-rig results table
    One row per rig with the floor, refresh, resync and daily budget to
    quote, each cell linked to the entry that holds its conditions. Cells
    with no figure say why the logbook declines to quote one.
2026-09-16 Put the footprint ledger in date order with unique stage letters
    Long cells move to a notes list under the table, the Flash% footnotes
    become a denominator-by-era table, and the two 2026-08-09 rows are
    flagged as computed against the pre-K slot rather than re-filed.
2026-09-16 Reword the Seeed board compatibility section of the wiring doc
    One identical/differs table, the RESE and pin-map tables kept, three
    rules with their figures, and one line of links to the 2026-07-05 power
    entries in place of the prose restating them.
2026-09-16 Move the vendor PDFs under hardware/datasheets and index the board docs
    The four carrier schematics join the panel datasheets, with a table of
    their own. The board README opens with a table of the docs beside it,
    the docs index gains the datasheets row, and the two order sub-READMEs
    and the placement verification record get their inbound links.
2026-09-16 Move the rev A first-article record out of BRINGUP.md into the archive
    Phases 0-2, the X-ray pointer and the Phase 3 items closed since move
    verbatim to archive/bringup-rev-a-first-article.md with an outcome banner.
    BRINGUP.md keeps the open Phase 3 queue and the 2026-08-23 sections. Two
    Phase 2 boxes whose bodies record passes are ticked; the EPD_VCC probe
    after hibernate they left open becomes its own open item.
2026-09-16 Reword BRINGUP.md into a board status table and the open Phase 3 queue
    The 2026-08-11 panel arrival and the 2026-08-12 soak start become dated
    entries in the archive record, with the VGH/VGL pre-regulation result as
    a closed item; the C1/C2 half stays open. The load-cap section and the
    soak's two part-to-part results link the clock-drift and power logbooks
    instead of restating their figures. Every open item keeps its protocol,
    figures and hedges.
2026-09-16 Move the rev B candidates out of the board README into a proposal register
    REV-B.md opens with a candidate / gate / expected / observed / date table,
    one row per candidate plus the 32k load caps filed 2026-08-23, and keeps the
    research per item under a neutral heading. The README points at it, and the
    two pointers in BRINGUP.md and docs/notes.md follow.
2026-09-16 Reword the board README: status block, parts table, closed-items table
    The status paragraph becomes a short block that links BRINGUP's board table
    and the logbook entries behind its figures. The BOM paragraph becomes a
    parts table with the FPC socket requirement and the J4 datum as their own
    subsections, and the dispositioned sign-off items and follow-up phases
    become one closed-items table. The panel readback research moves to the
    datasheets README; REV-B.md keeps the rev B conclusion and a pointer.
2026-09-16 Point the board CLAUDE.md at the split bring-up record and the rev B register
2026-09-16 Label the post-hoc closures in the kicad-happy review and reflow it
2026-09-16 Point schematic finding 6 at the measured FC-135 rates
2026-09-16 Trim the table cells over 200 characters in the hardware docs
    Ten cells introduced by the hardware docs round exceeded 200 characters.
    README: the crystal bias rationale moves to a paragraph under the pin
    map, the FPC row splits into footprint and placement, the firmware row
    points at the pin map, the closed-items intro names the first-article
    record once. ORDERING: the J3 row splits into orientation and datum, the
    J4 geometry points at the README BOM derivation. Datasheets README: the
    UC8151D register values become their own table.
2026-09-16 Reconcile the device-session skill with the logbooks and drop its session figures
    The parked-chip rule now says the park may or may not survive esptool's
    closing reset, which is what the validation log records. The "Reading a
    measurement" section keeps its rules and points at the C6 budget entry in
    the power logbook for the figures instead of restating them. The
    MOCK_DISPLAY_DATA trap and the ETA9740 drain become pointers to the rule
    file and the wiring doc that own them.
2026-09-16 Move the stale-LP-binary and stale-sdkconfig case histories to the build doc
    The ulp and build rule files keep the rule and a pointer; the dated
    evidence, the upstream issue and what each case cost live under the ULP
    builds and sdkconfig sections of docs/build-system.md. The ULP word counts
    leave the rule file, which already says to read them from the size check.
2026-09-16 Point the hardware CLAUDE.md at the pcb-fab stamp guarantee and prefix its script paths
    The stamp guarantee is stated once, in the pcb-fab skill; the CLAUDE.md
    keeps the two imperatives. The orientation warning loses its session
    narration. generate.py, pcb.py and check_fab.py carry their directories.
    107 of 110 loaded lines.
2026-09-16 Shorten the device-state rule in CLAUDE.md and drop the unsourced estimate ratio
2026-09-16 Restore the decode-artifact and no-transient captures to the C6 budget entry
    Both facts were cut from the power logbook on 2026-07-26 when the session
    log collapsed into conclusions, and survived only in the device-session
    skill until that skill stopped restating figures. The flat 4c0bbef capture
    returns as an open item.
2026-10-27 Archive the J3/J4 geometry proofs and repoint their citations
    The STEP, drawing and annotated-render proofs behind the J3 and J4 respins
    lived only in the untracked out/, while generator comments, verify/ checks,
    both local footprints' descr and the board docs cited them as evidence.
    Move them to archive/proofs/ with an index, rewrite their internal paths
    (absolute ones included) to run from the board directory, and keep the HRO
    datasheet with the other untracked part datasheets.
    [thermometer-c6.kicad_pcb]
2026-10-27 Require an archived, annotated proof for part geometry claims
    The pcb-edit skill now says what a footprint, orientation, pin-1 or datum
    proof contains (verdict, scripts, annotated overlay against board copper,
    independent sources) and that it lives in archive/proofs/, not out/.
